tarori/FPGA-Core/README.md

# FPGA Core Board

* Artix-7 XC7A35T-2FTG256C
* USB Bus Powered
* 80 I/O from Mezzanine Connectors
* On-Board JTAG and 300Mbps FIFO by FT2232H
* 256Mbit Hyper-RAM

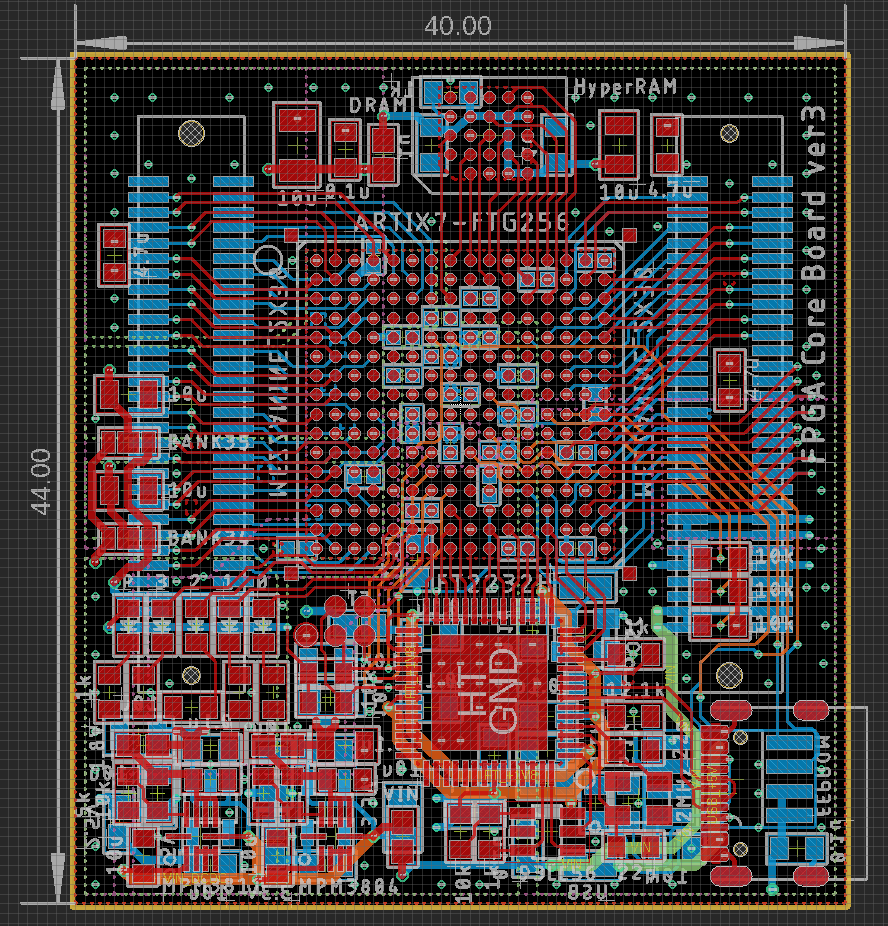
[picture p1: image/board_cad.png]
