tarori/FPGA-Core/readme.txt

All vias with 0.35mm drill diameter should be filled and capped.
