tarori/FPGA-Core/(commit log)

2023-04-20 こんな感じ
    [ADC3_FPGA_BGA.brd, ADC3_FPGA_BGA.sch]
2023-06-03 メザニンコネクタ
    [ADC3_FPGA_BGA.brd, ADC3_FPGA_BGA.sch]
2023-06-09 4層DRC
    [ADC3_FPGA_BGA.brd, ADC3_FPGA_BGA.sch]
2023-06-30 コネクタをピン名に変更
    [ADC3_FPGA_BGA.brd, ADC3_FPGA_BGA.sch]
2023-06-30 FT2232のEEPROMの配線を修正
    [ADC3_FPGA_BGA.brd, ADC3_FPGA_BGA.sch]
2023-07-04 古いファイルを削除
    [ADC3_10M.brd, ADC3_10M.sch, ADC3_2M.sch, ADC3_FPGA.brd, ADC3_FPGA.sch, ADC3_FPGA_BGA.brd]
2023-07-16 Artix-7 途中
    [ADC3_FPGA_BGA.brd, ADC3_FPGA_BGA.sch]
2023-07-16 via打てば終わり
    [ADC3_FPGA_BGA.brd, ADC3_FPGA_BGA.sch]
2023-07-29 OSCを追加して再発注
    [ADC3_FPGA_BGA.brd, ADC3_FPGA_BGA.sch]
2024-06-30 長穴修正
    [ADC3_FPGA_BGA.brd, ADC3_FPGA_BGA.sch]
